banatanflorin/reductor/Memoriu justificativ de calcul.pdf

## MEMORIU JUSTIFICATIV DE CALCUL

Pm ≔3.8 kW

nm ≔2100 rpm

itot≔5

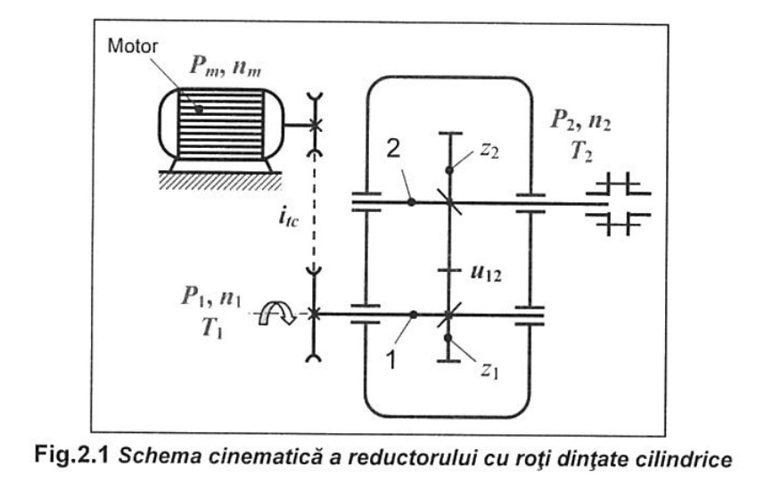
[picture p1: figure]

### 1.CALCULE PRELIMINARE:

Se adoptă itcpreliminar=1.8...2.0 => itcpreliminar≔2

u12≔――――=

itot

itcpreliminar

2.5

Se adoptă u | cu ajutorul tabelului 2.3 (pag. 24): 12STAS | u12STAS≔2.5

Se aleg materialele pentru pinion si roata:
-materialul pentru pinion: 42CrMo4 => HB1≔300 MPa -materialul pentru roată: 41Cr4 => HB2≔270 MPa

σHlim1≔1.8 ⋅HB1+200 MPa =740 MPa

σHlim2≔1.8 ⋅HB2+200 MPa =686 MPa

Se adoptă numărul de dinți, pe baza tabelului 2.1: z1≔28

z2≔z1

⋅u12STAS=70 | => | z2≔71

u12≔―=

z2
z1

2.536

ε12≔――――⋅ =

u12-u12STAS
u12STAS | 100 1.429

itc≔――=

itot

u12

1.972

10

n1≔――=

nm

itc

⎛⎝1.065 ⋅ 10³ ⎞
⎠ rpm

n2≔――=

n1

u12

420 rpm

Verificare: n2≔――=

nm

itot

420 rpm

Se adoptă, cu ajutorul tabelului 2.4:
-randamentul transmisiei prin curele trapezoidale: ηtc≔0.93 -randamentul angrenajului cu roți dințate cilindrice: ηc≔0.97 -randamentul unei perechi de rulmenți: ηrul≔0.999

P1≔Pm ⋅ηtc ⋅ηrul=3.53 kW

P2≔P1

⋅ηc

⋅ηrul=3.421 kW | n1=⎛⎝1.065 ⋅ 10³ ⎞
⎠ rpm

T1≔―――⋅ =

9550
10000

P1
n1

⎛⎝3.023 ⋅ 10⁴ ⎞
⎠ N ⋅mm

T2≔―――⋅ =

9550
10000

P2
n2

⎛⎝7.428 ⋅ 10⁴ ⎞
⎠ N ⋅mm

### 2.PREDIMENSIONAREA ANGRENAJULUI:

Se adoptă unghiul de inclinare a danturii pe cilindrul de divizare: β≔0 °

Se adoptă coeficientul lățimii dintelui: ψa≔0.24

Pe baza anexei 2.4, de la pagina 113, se adoptă factorul de utilizare, știind că transmisia este uniformă: KA≔1

Se adoptă factorul dinamic: KV≔1.2

Se adoptă factorul pentru solicitarea de contact, cu ajutorul anexei 2.6, pag. 115: ψd≔―――⋅ =

u12+1
2

ψa 0.424
KHβ≔1+0.25 ⋅ψd=1.106

Se adoptă factorul repartiției sarcinii în plan frontal: KHα≔1.2

Cu ajutorul anexei 2.8 de la pagina 118, se adoptă factorul de elasticitate a materialului roților dințate: ZE≔189.8 MPa

11

Se calculează factorul înclinării dinților pentru solicitarea de contact: Zβ≔1

Se calculează factorul punctului de rostogolire: ZH≔2.49 ⋅Zβ=2.49

Se adoptă factorul de gradului de acoperire: Zε≔0.95

Se citesc de pe graficul din anexa 2.10 de
la pagina 120, factorul de corelație a
tensiunilor de încovoiere la baza dintelui: YSa1≔1.63
YSa2≔1.8

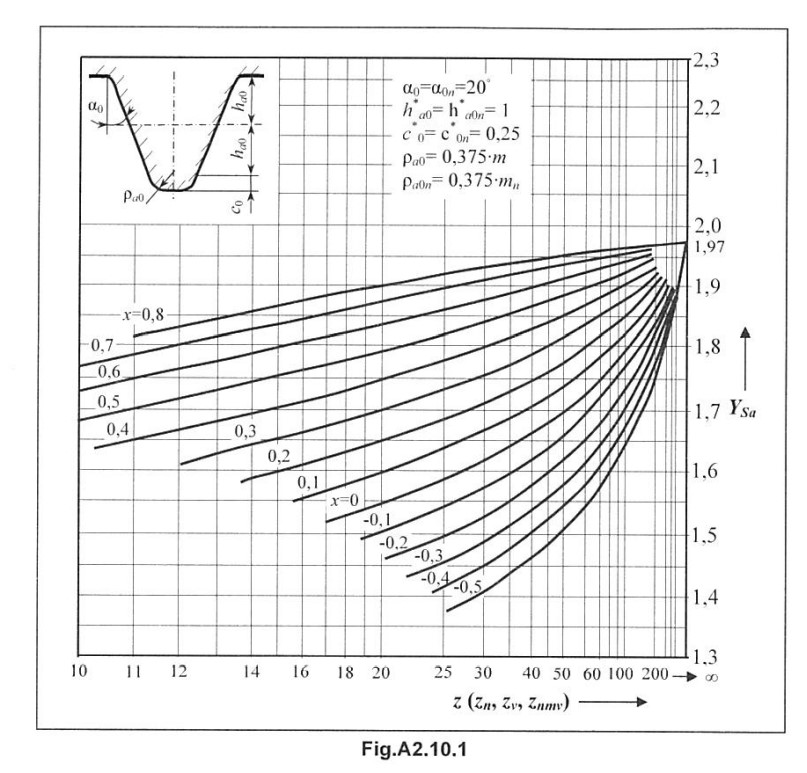
[picture p2: figure]

Cu ajutorul anexei 2.14, se adoptă factorii durabilității ZN1 ,ZN2

Se adoptă: Lh≔10000

Numărul de dinți în contact: χ ≔ și 1 | 1 | χ2≔1

NL1≔60 ⋅n1

⋅Lh

⋅χ1=⎛⎝6.692 ⋅ 10⁷ ⎞
⎠ Hz

NL2≔60 ⋅n2

⋅Lh

⋅χ2=⎛⎝2.639 ⋅ 10⁷ ⎞
⎠ Hz

Din graficul din anexa 2.14 se extrage factorii durabilității: ZN1≔1
ZN2≔1

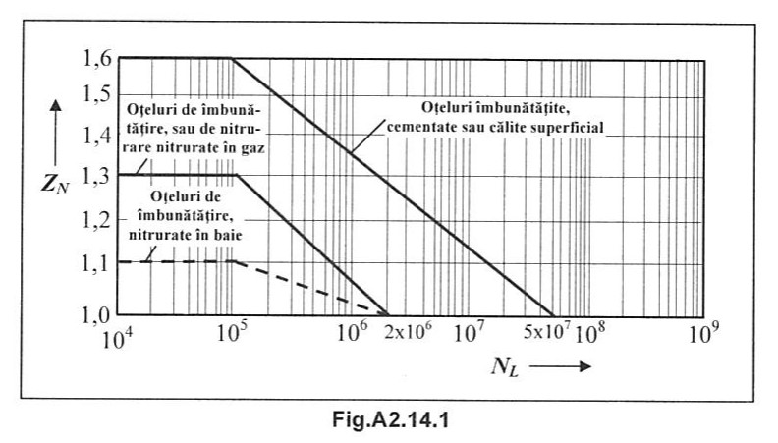
[picture p3: figure]

Din anexa 2.13, tabelul A 2.13.1 se adoptă coeficientul de siguranță minim pentru solicitarea de contact: SHmin≔1.15

σHP1≔――――=

σHlim1 ⋅ZN1

SHmin

643.478 MPa σHP2≔――――= σHlim2 ⋅ZN2 SHmin
596.522 MPa

=> σHP≔min⎛⎝σHP1 ,σHP2⎞
⎠=596.522 MPa

12

aWnec≔⎛⎝u12+1⎞
⎠
⋅ | =

3 ―――――――⋅

T ⋅ | ⋅ | ⋅ | ⋅ 1 KA KV KHβ KHα
2 ⋅ψ ⋅ | ⋅ a u12 σHP
| | | 2

⎛⎝ZE ⋅ZH ⋅Z ⋅ ε Zβ

⎞
⎠

2
99.684 mm

m≔―――=

2 ⋅aWnec
z1+z2

2.014 mm

Modulul m se standardizează, cu ajutorul tabelului 2.5 (pagina 27): m≔2 mm

a≔――――=

m⋅ ⎛⎝z1+z2

⎞
⎠
2

### 99 mm

Se standardizează distanța dintre axe, cu ajutorul tabelului 2.6 (pagina 27): aW ≔100 mm
Dacă aW >a atunci trebuie să se respecte condiția:
aW -a=1 mm
2 ⋅m=4 mm =>aW -a≤2 ⋅m

Unghiul de angrenare de referință: α≔20 °

Unghiul de angrenare real: αW ≔acos | =

⎛
⎜
⎝

――⋅

a
aW

cos ((α))

⎞
⎟
⎠

21.519 °

Se calculează involutele unghiurilor de angrenare:

invα≔tan((α))-――=

α⋅π
180 °

0.014904 rad

invαW ≔tan⎛⎝αW⎞
⎠-―――=

αW ⋅π
180 °

0.018716 rad

xs≔―――――⋅ | =

invαW -invα
2 ⋅ tan((α))

⎛⎝z1+z2

⎞
⎠ 0.518
x1≔―+ | =

xs
2

⋅

⎛
⎜
⎝

0.5-―

xs
2

⎞
⎟

⎠ ――――

log⎛⎝u12⎞
⎠

log

⎛
⎜

⎝――

z ⋅ 1 z2
100

⎞
⎟
⎠

0.334

x2≔xs-x1=0.184

y≔―――=

aW -a
m

0.5

Δy≔xs-y=0.018
13

### 3. DIMENSIONAREA ȘI VERIFICAREA ANGRENAJULUI:

### 3.1 Calculul elementelor geometrice:

Calculul diametrelor cercurilor de divizare:

d1≔m⋅ z1=56 mm

d2≔m⋅ z2=142 mm

Verificare: a≔―――=

d1+d2
2

### 99 mm

Calculul diametrelor cercurilor de bază:

db1≔d1

⋅ cos ((α))=52.623 mm

db2≔d2

⋅ cos ((α))=133.436 mm

Calculul diametrelor cercurilor de rostogolire:

dw1≔d1

⋅―――=

cos ((α))
cos ⎛⎝αW⎞
⎠

56.566 mm

dw2≔d2

⋅―――=

cos ((α))
cos ⎛⎝αW⎞
⎠

143.434 mm

Verificare: aW ≔―――=

dw1+dw2
2

100 mm

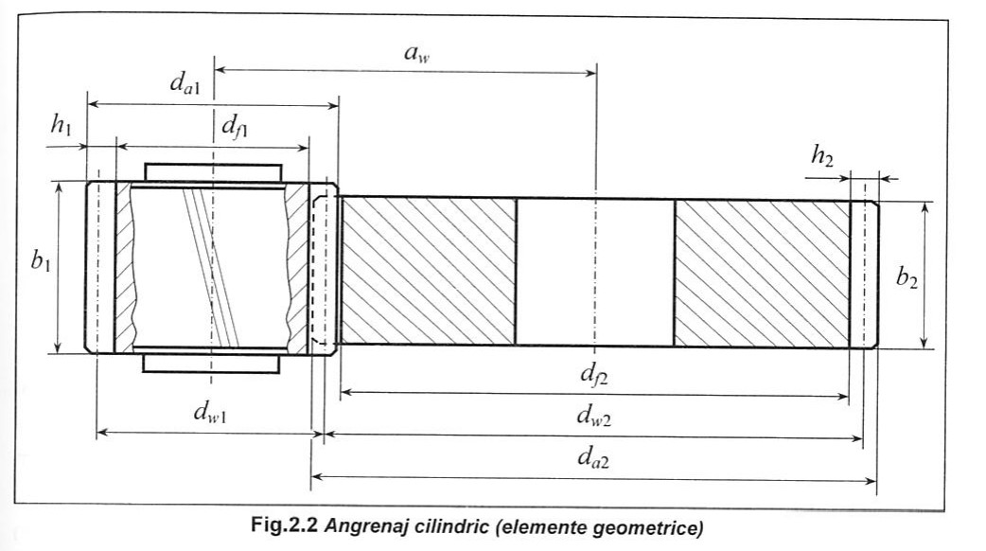
[picture p4: figure]

Se adoptă coeficientul înălțimii capului de referință: han≔1

Se adoptă coeficientul jocului de referință la capul dintelui: cn≔0.25 14

Calculul diametrelor cercurilor de cap:

da1≔m⋅ ⎛⎝z1+2 ⋅ ⎛⎝han+x1-Δy⎞ ⎠

⎞
⎠=61.263 mm

da2≔m⋅ ⎛⎝z2+2 ⋅ ⎛⎝han+x2-Δy⎞ ⎠

⎞
⎠=146.663 mm

Calculul diametrelor cercurilor de picior:

df1≔m⋅ ⎛⎝z1-2 ⋅ ⎛⎝han+cn-x1

⎞
⎠

⎞
⎠=52.337 mm

df2≔m⋅ ⎛⎝z2-2 ⋅ ⎛⎝han+cn-x2

⎞
⎠

⎞
⎠=137.737 mm

Calculul unghiurilor de presiune pe cercurile de cap:

αa1≔acos | =

⎛
⎜
⎝

――⋅

d1

da1

cos ((α))

⎞
⎟
⎠

30.799 °

αa2≔acos | =

⎛
⎜
⎝

――⋅

d2

da2

cos ((α))

⎞
⎟
⎠

24.52 °

Calculul grosimii dinților pe cercurile de divizare:

S1≔⎛⎝0.5 ⋅π +2 ⋅x1 | ⋅ tan((α))⎞
⎠

⋅m=3.628 mm

S2≔⎛⎝0.5 ⋅π +2 ⋅x2 | ⋅ tan((α))⎞
⎠

⋅m=3.41 mm

Calculul grosimii dinților pe cercurile de cap:
invαa1≔tan⎛⎝αa1⎞ | ⎠-―――= α ⋅ a1 π 180 °
0.058554 rad
invαa2≔tan⎛⎝αa2⎞ | ⎠-―――= α ⋅ a2 π 180 °
0.028195 rad

Sa1≔⎛⎝

⎛⎝

invα-invαa1⎞
⎠
| ⋅m⋅ z1+S1

⎞
⎠

⋅―――=

cos ((α))
cos ⎛⎝αa1⎞
⎠

1.295 mm

Sa2≔⎛⎝

⎛⎝

invα-invαa2⎞
⎠
| ⋅m⋅ z2+S2

⎞
⎠

⋅―――=

cos ((α))
cos ⎛⎝αa2⎞
⎠

1.573 mm

Calculul înălțimii dintelui:

h≔m⋅ ⎛⎝2 ⋅han+cn-Δy⎞ | ⎠=4.463 mm
15

Calculul lățimii danturii celor două roți:

b2≔ψa

⋅aW =24 mm

b1≔b2+3 mm =27 mm

Calculul gradului de acoperire:

εα≔――――――――――――――=

d
a1
- | + | -

### 2 db1

2 - da2

### 2 db2

2 2 ⋅aW ⋅ sin⎛⎝αW⎞
⎠
2 ⋅π⋅m⋅ cos ((α))

1.598

Elemente de control:

Calculul numărului de dinți:

N1≔z1

⋅――+ =

α
180 °

0.5 3.611 => N1≔4

N2≔z2

⋅――+ =

α
180 °

0.5 8.389 => N2≔8

Calculul cotelor peste dinți:

WN1≔m⋅ ⎛⎝π⋅ ⎛⎝N1-0.5⎞
⎠+z1

⋅invα⎞
⎠

⋅ cos ((α))+2 ⋅m⋅x1

⋅ sin((α))=21.906 mm

WN2≔m⋅ ⎛⎝π⋅ ⎛⎝N2-0.5⎞
⎠+z2

⋅invα⎞
⎠

⋅ cos ((α))+2 ⋅m⋅x2

⋅ sin((α))=46.523 mm

Calculul corzii constante și înălțimea la coarda constantă:

Sc1≔m⋅ | =

⎛
⎝0.5 ⋅π⋅ cos ((α)) +

2
x ⋅ 1 sin((2 ⋅α))

⎞
⎠ 3.204 mm
Sc2≔m⋅ | =

⎛
⎝0.5 ⋅π⋅ cos ((α)) +

2
x ⋅ 2 sin((2 ⋅α))

⎞
⎠ 3.011 mm

hc1≔0.5 ⋅ ⎛⎝da1-d1-Sc1 ⋅ tan((α))⎞ ⎠=2.048 mm

hc2≔0.5 ⋅ ⎛⎝da2-d2-Sc2 ⋅ tan((α))⎞
⎠=1.784 mm

Abateri și toleranțe:

Conform anexei 2.20 de la pagina 135, se vor stabili toleranțele și abaterile pentru angrenaj:

Adopt treapta de precizie: 7
Adopt tipul ajustajului: B
16

Din tabelul A2.20.1, se adopta toleranța bătăi radiale a danturii: Fr1≔36 μm
Fr2≔50 μm

Din tabelul A2.20.2, se adoptă abaterea minimă a cotei peste dinți: EWS1≔100 μm
EWS2≔120 μm

Din tabelul A2.20.3, se adoptă toleranța cotei peste dinți:
TW1≔80 μm
TW2≔100 μm

Din tabelul A2.20.4, se adoptă abaterea superioară a grosimii dintelui pe coarda constantă:
ECS1≔100 μm
ECS2≔140 μm

Din tabelul A2.20.5, se adoptă toleranța grosimii dintelui pe coarda constantă: TC1≔90 μm
TC2≔140 μm

Verificarea restricțiilor funcțional-constructive și de control:

Pentru evitarea funcționării neuniforme trebuie să fie îndeplinită condiția:

1.3≤εα≤2 | ( ε = | ) α 1.598

Roțile sunt efectuate din oțeluri de cementare sau călite superficial, astfel trebuie să se îndeplinească restricțiile de evitare a ascuțirii dinților:

Sa1≥0.4 ⋅m | Sa2≥0.4 ⋅m
(S = | , | , | ) a1 1.295 mm Sa2=1.573 mm m=2 mm

Restricțiile de evitare a interferenței dinților:

x1min≔―――=

14-z1
17
| -0.824 | | x2min≔―――=

14-z2
17

-3.353

x1min≤x1 | x2min≤x2

17

### 3.2 VERIFICAREA ANGRENAJULUI:

Se determina viteza periferică a angrenajului:

ν≔――――=

π⋅dw1 ⋅n1
6

3.303 ―m
s

Yβ≔1

ZH≔ | =
―――2――― sin⎛ | ⋅ ⎝αW⎞
| ⎠ cos ⎛⎝αW⎞ ⎠

2.421

Zε≔ | =
――

4-εα
3

0.895

Se adoptă ulei TIN 82 EP (TIN-ulei pentru transmisii industriale, EP-adezivi de extreme presiuni)

Se adoptă vâscozitatea cinematică, conform anexei 2.18,tabelul A2.18.2 de la pagina 132: v≔85 stokes

Cu ajutorul anexei 2.18,
graficul A2.18.1, se va
adopta factorul de
ungere: ZL≔0.98

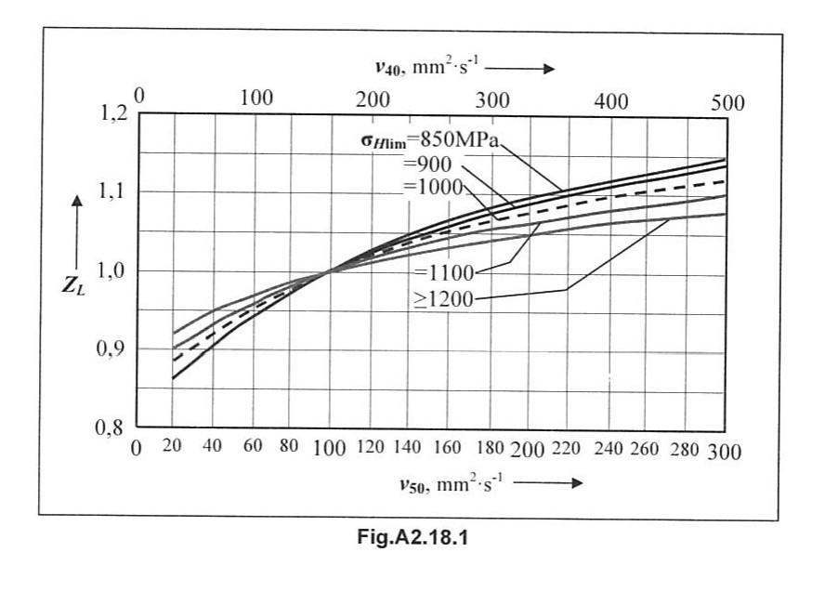
[picture p5: figure]

Conform anexei 2.15, se va adopta rugozitatea flancurilor și a zonelor de racordare:

Din tabelul A2.15.1 => R ≔ | și a1 | 0.4 | Ra2≔0.4
Rz1≔4.4 ⋅Ra1 | =

0.97 1.809

Rz2≔4.4 ⋅Ra2 =

0.97 1.809

Rz100≔―――⋅ | | =

Rz1+Rz2
2

―100―mm―aW
1.809

18

Conform graficului A2.15.1, se adoptă factorul rugozității flancurilor: ZR≔1.08

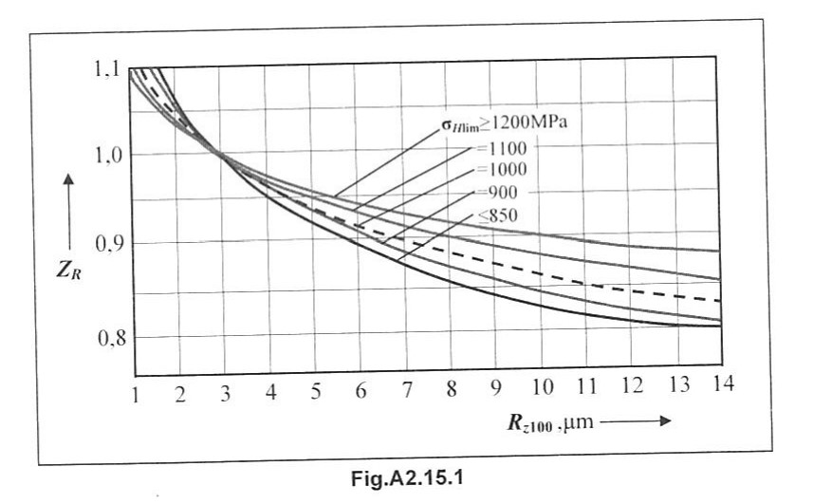
[picture p6: figure]

Conform anexei 2.16, se va adopta factorul de viteză: Zv≔0.94

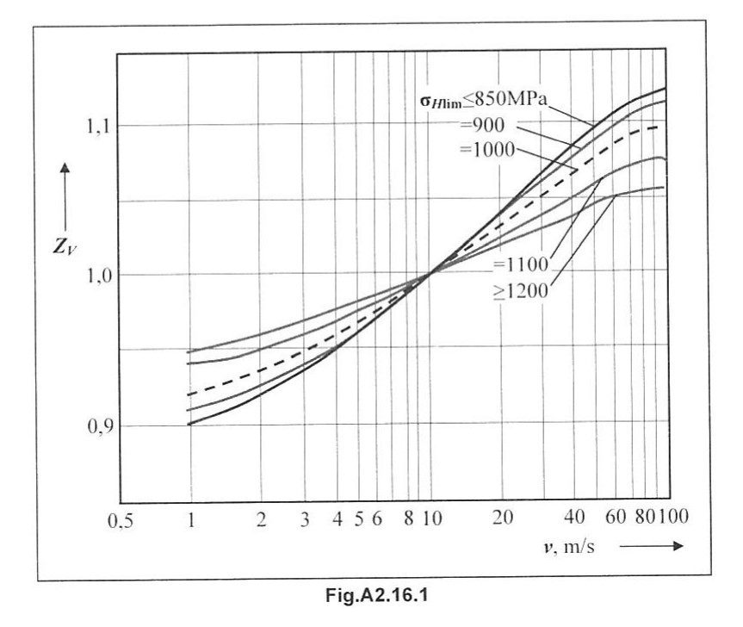
[picture p7: figure]

Conform anexei 2.17, se va adopta factorul raportului durităților flancurilor dințate:

HB≔min⎛⎝HB1
,HB2

⎞
⎠=270 MPa

ZW ≔1.2-―――――=

HB-130 MPa
1700 MPa

1.118

Tensiunea efectivă maximă de contact:

σH≔―――――⋅ | =
ZE ⋅Z ⋅ | ⋅ ε ZH Zβ
aW
――⋅ | ⋅ | ⋅ | ⋅ | ⋅

T1
2 ⋅ b2

KA KV KHβ KHα ――――

⎛⎝u12+1⎞
⎠

3

u12

543.65 MPa
19

Factorul de siguranță la solicitarea de contact:

ZN≔1

SH≔―――⋅ | ⋅ ⋅ | ⋅ ⋅ | =

σHlim2
σH

ZN ZL ZR Zv ZW 1.403

=> SH ≥SHmin
SHmin=1.15

Factorii rugozității flancurilor pentru solicitarea de încovoiere: YR1≔1 și YR2≔1

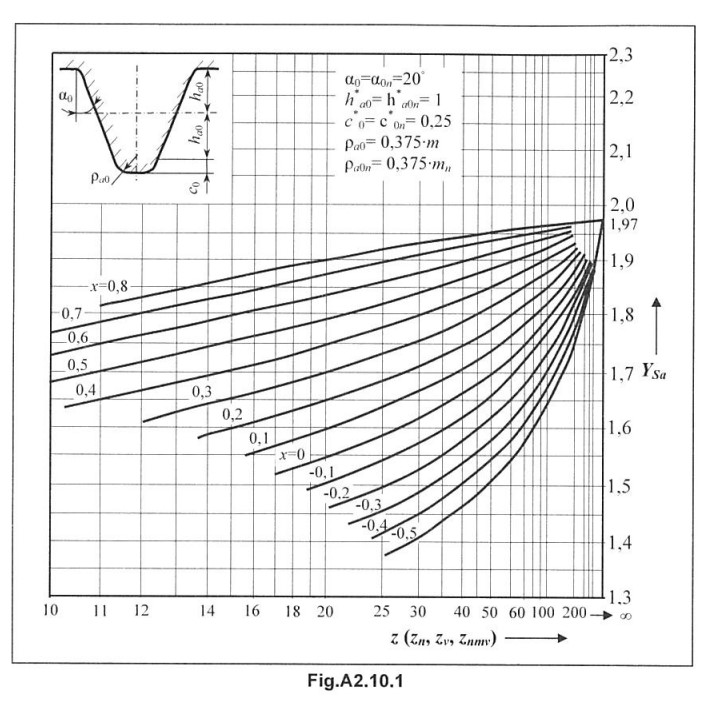
[picture p8: figure]

Cu ajutorul anexei 2.10, graficul
A2.10.1, se va adopta factorul de corecție a tensiunilor de încovoiere la baza dintelui: YSA≔1.75

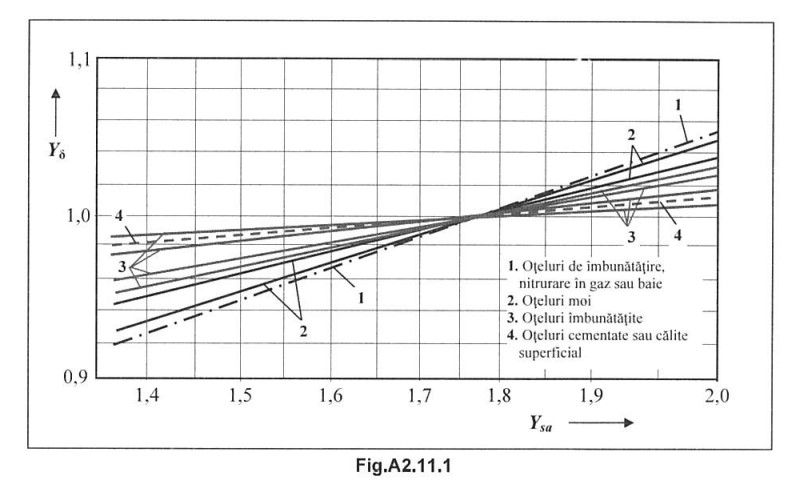
[picture p9: figure]

Cu ajutorul anexei 2.11, graficul A2.11.1, se va adopta factorul relativ de sensibilitate al materialului la concentratorul de tensiuni de la baza dintelui la durabilitate nelimitată: Yδ≔0.99

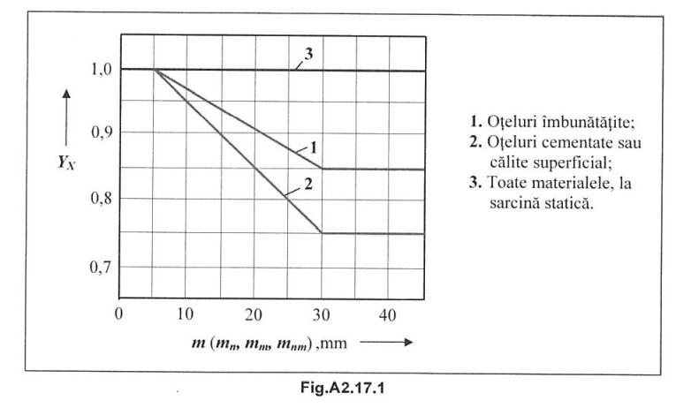
[picture p10: figure]

Cu ajutorul anexei 2.17, se va adopta factorul dimensional pentru solicitarea de încovoiere: Yx≔1

20

### 4. CALCULUL FORȚELOR DIN ANGRENAJ

Forțele tangențiale:

Ft1≔――=

2 ⋅T1

dw1

⎛⎝1.069 ⋅ 10³ ⎞

⎠ N | Ft2≔Ft1=⎛⎝1.069 ⋅ 10³ ⎞
⎠ N

Forțele radiale:

Fr1≔Ft1 ⋅ tan((α))=389.045 N | Fr2≔Fr1=389.045 N

Forțele axiale:

Fa1≔Ft1 ⋅ tan((β))=0 N | Fa2≔Fa1=0 N

Forțele normale:

Fn1≔ F
t1
+ | + | =

### 2 Fr1

### 2 Fa1

2 ⎛⎝1.137 ⋅ 10³ ⎞
⎠ N

Fn2≔Fn1=⎛⎝1.137 ⋅ 10³ ⎞
⎠ N

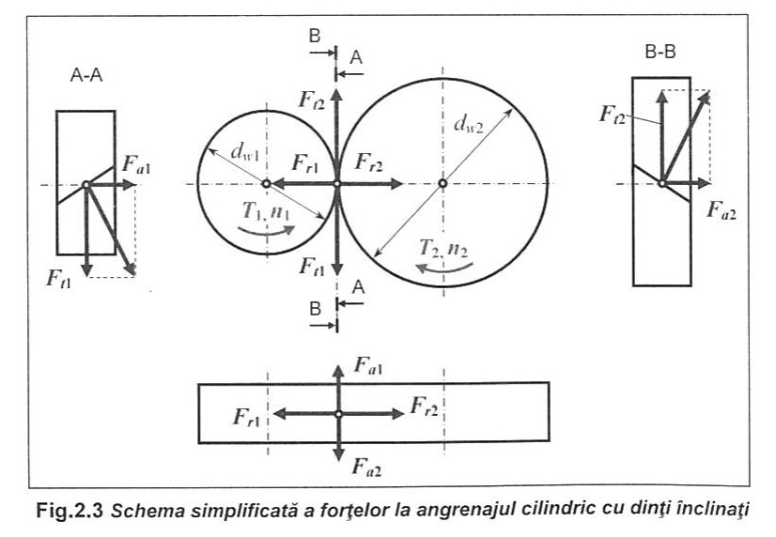
[picture p11: figure]

### 5. PROIECTAREA ȘI CALCULUL ARBORILOR:

### 5.1 Proiectarea formei arborelui de intrare din reductor:

Materialul arborelui de intrare coincide cu materialul pinionului, deci arborele de intrare este efectuat din : 42CrMo4

21

Cu ajutorul anexei 2.1 obținem rezistența la rupere a arborelui de intrare: Rm1≔950 MPa

Tc1≔T1

⋅――――=

550 MPa

Rm1

17.502 N ⋅m

Cu ajutorul tabelului 3.1, pagina 58, se standardizează momentul transmisibil și diametrul nominal al capătului de arbore:

Tc1≔21.2 N ⋅m | dca1≔20 mm

Cu ajutorul tabelului 3.2, pagina 58, se adoptă lungimea capetelor de arbore:

lca1≔36 mm

Cu ajutorul anexei 3.1 se adoptă dimensiunile penei de fixare:

bpana1≔6 mm | hpana1≔6 mm

tpana1≔3.5 mm

lpana1≔lca1-4 mm =32 mm

Asigurarea de capăt de arbore:

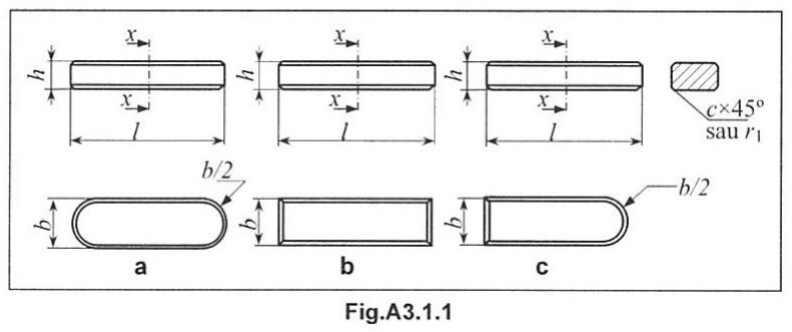
[picture p12: figure]

dca1≤28 => Asigurarea este realizată cu un șurub și două șaibe

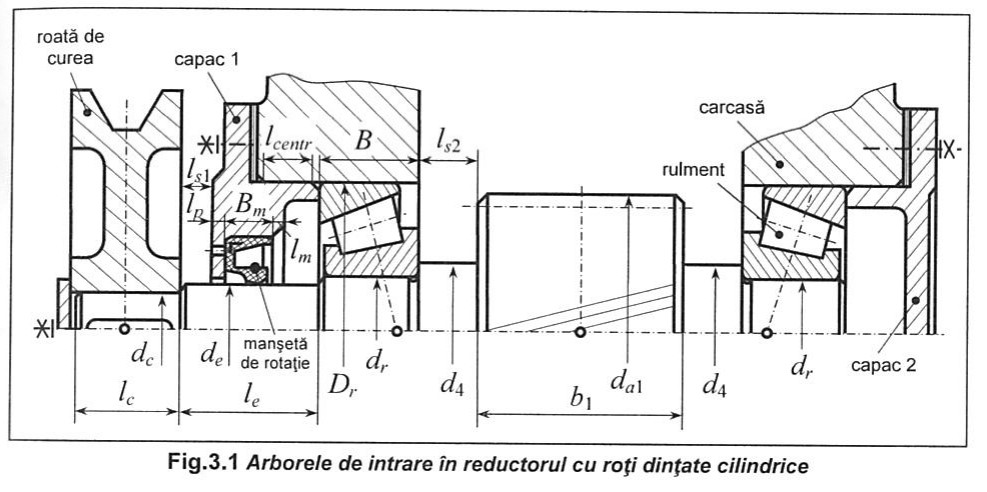
[picture p13: figure]

Alegem dimensiunile șurubului cu ajutorul tabelului 3.3:

Dmax1≔28 mm | bsurub1≔5 mm | filet M6 | d1surub1≔7 mm
gsurub1≔2 mm | hsurub1≔5 mm | l
| | surub1≔16 mm | fmax1≔3 mm
22

Alegem dimensiunile pentru șaibele de siguranță cu ajutorul tabelului 3.4:

d2saiba1≔6.4 mm | g1saiba1≔0.5 mm l
| | saiba1≔18 mm | rsaiba1≔4 mm
D1saiba1≔12.5 mm | bsaiba1≔4.5 mm | l1saiba1≔9 mm | r1saiba1≔4 mm

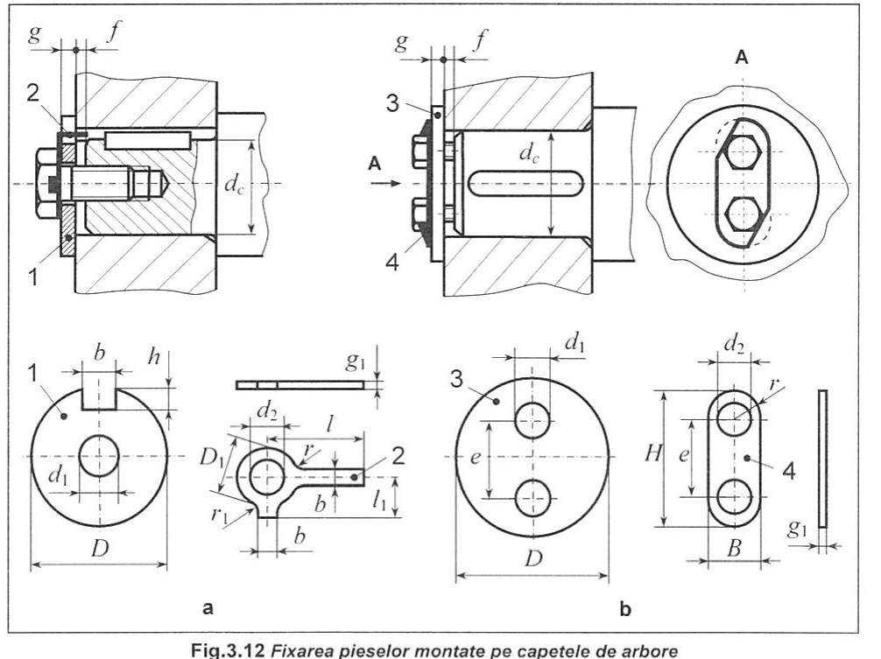
[picture p14: figure]

Se adoptă manșeta de rotație cu ajutorul anexei 3.6:

de1≔1.2 ⋅dca1=24 mm

=> de1STAS≔25 mm

Diametrul exterior al manșetei: Dm1≔40 mm

Lățimea manșetei: Bm1≔7 mm

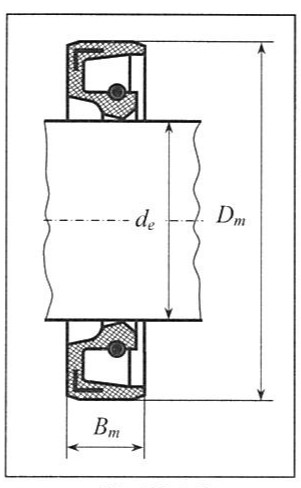
[picture p15: figure]

Pentru dimensionarea rulmenților radiali cu bile ne ajutam de anexa 3.2 și de condiția: dr1≥de1STAS

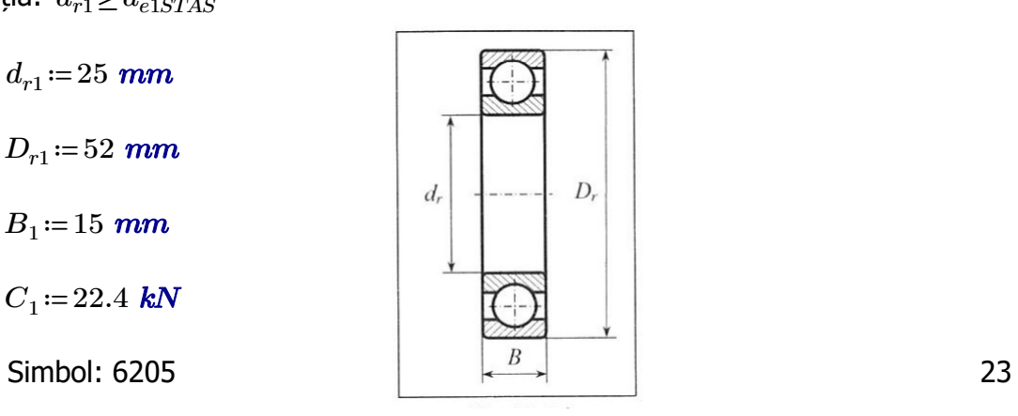
[picture p16: figure]
Simbol: 6205

dr1≔25 mm

Dr1≔52 mm

B1≔15 mm

C1≔22.4 kN

Se adoptă cota de siguranță: l
s1≔8 mm

d41≔dr1+5 mm =30 mm

### 5.2 Proiectarea formei arborelui de ieșire din reductor:

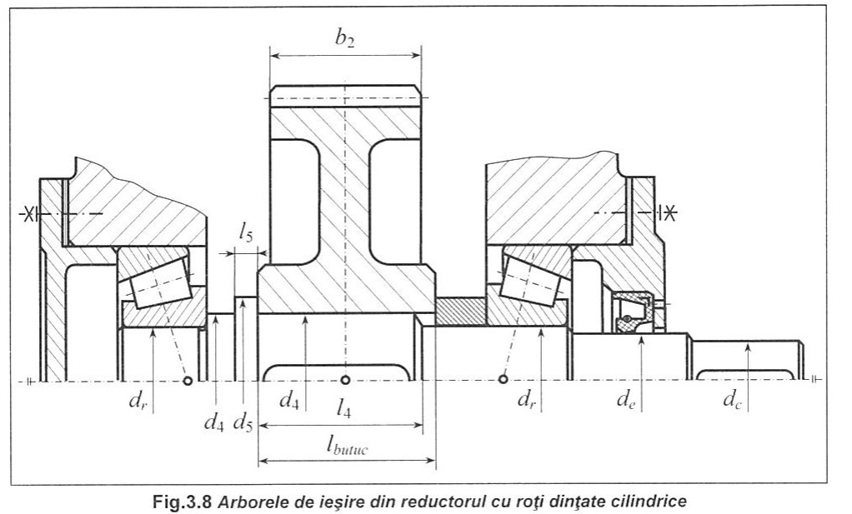
[picture p17: figure]

Arborele de ieșire este efectuat din materialul: 1C55

Cu ajutorul tabelului 3.1 obținem rezistența la rupere a arborelui de ieșire: Rm2≔720 MPa

Tc2≔T2

⋅――――=

550 MPa

Rm2

56.745 N ⋅m

Cu ajutorul tabelului 3.1, pagina 58, se standardizează momentul transmisibil și diametrul nominal al capătului de arbore:

Tc2≔69 N ⋅m

dca2≔28 mm

Cu ajutorul tabelului 3.2 se adoptă lungimea capetelor de arbore: lca2≔60 mm

Cu ajutorul anexei 3.1 se adoptă dimensiunile penei paralele:

bpana2≔8 mm | hpana2≔7 mm
lpana2≔50 mm | tpana2≔4 mm
24

Asigurarea de capăt de arbore:

dca2≤28 => Asigurarea este realizată cu un șurub și două șaibe

Alegem dimensiunile șurubului cu ajutorul tabelului 3.3:

Dmax2≔36 mm | bsurub2≔8 mm | filet: M6 | d1surub2≔7 mm
gsurub2≔2.5 mm | hsurub2≔7 mm | l
| | surub2≔16 mm | fmax2≔3 mm

Alegem dimensiunile pentru șaibele de siguranță cu ajutorul tabelului 3.4:

d2saiba2≔6.4 mm | bsaiba2≔4.5 mm | l
| | saiba≔18 mm | rsaiba2≔4 mm
D1saiba2≔12.5 mm | g1saiba2≔0.5 mm l1saiba2≔9 mm | r1saiba2≔4 mm

Se adoptă manșeta de rotație cu ajutorul anexei 3.6:

de2≔1.2 ⋅dca2=33.6 mm

de2STAS≔35 mm

Diametrul exterior al manșetei: Dm2≔50 mm

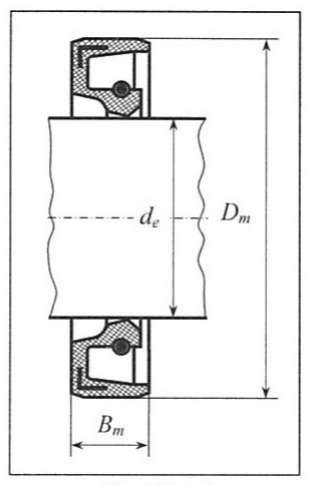
[picture p18: figure]

Lățimea manșetei: Bm2≔8 mm | 25

Pentru dimensionarea rulmenților radiali cu bile ne ajutam de anexa 3.2 și de condiția: dr2≥de2STAS

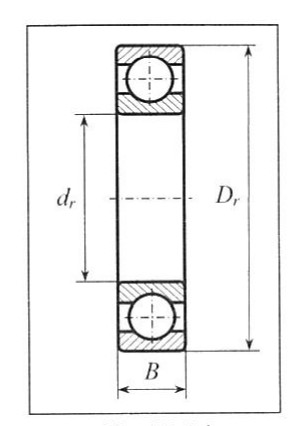
[picture p19: figure]

dr2≔35 mm

Dr2≔72 mm

B2≔16 mm

C2≔33.5 kN

Simbol: 6207

d42≔dr2+4 mm =39 mm

Se adoptă lungimea butucului: lbutuc≔50 mm

l4≔lbutuc-3 mm =47 mm

### 6. PROIECTAREA FORMEI CONSTRUCTIVE A ROȚII DINȚATE:

Roțile dințate sunt efectuate din
materialul: 42CrMo4

δrd≔3 ⋅m=6 mm

δ1rd≔0.28 ⋅ b2=6.72 mm

dcrd≔1.6 ⋅d42=62.4 mm

dird≔df2-2 ⋅ δrd=125.737 mm

lrd≔1.3 ⋅d42=50.7 mm

dgrd≔0.5 ⋅ ⎛⎝dird+dcrd⎞
⎠=94.069 mm

dord≔――――=

dird-dcrd
4

15.834 mm

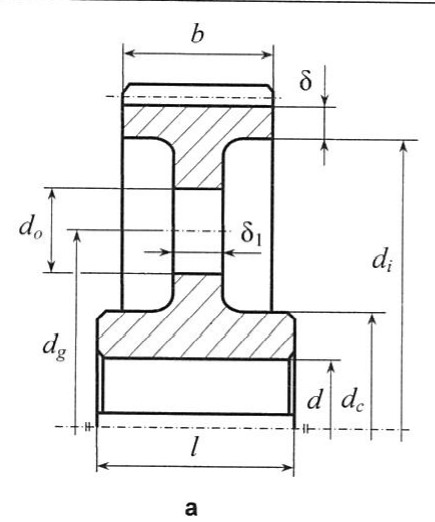
[picture p20: figure]

26

### 7. PROIECTAREA CARCASEI REDUCTORULUI ȘI A ACESORIILOR CARCASEI:

### 7.1 Proiectarea carcasei:

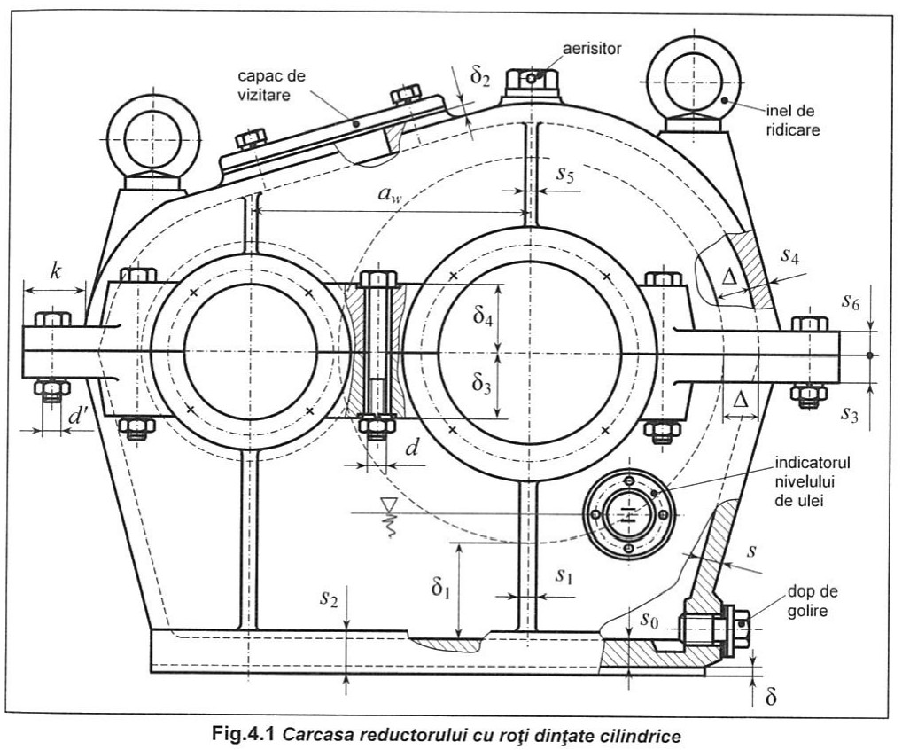
[picture p21: figure]

Grosimea peretelui interior: s≔0.06 ⋅aW =6 mm => s≥5 mm

Grosimea fundului carcasei: s0≔1.25 ⋅ s=7.5 mm

Grosimea nervurilor carcasei inferioare: s1≔0.8 ⋅ s=4.8 mm

Dimensiunile tălpii reductorului: s2≔2 ⋅ s=12 mm

δ≔0.4 ⋅ s=2.4 mm

Grosimea flanșei carcasei inferioare: s3≔1.5 ⋅ s=9 mm

Grosimea carcasei superioare: s4≔0.85 ⋅ s=5.1 mm

Grosimea nervurilor carcasei superioare: s5≔0.8 ⋅ s4=4.08 mm

Grosimea flanșei carcasei superioare: s6≔1.5 ⋅ s4=7.65 mm | 27

Distanța minimă de la roțile dințate la pereții carcasei:
Δ1≔1.2 ⋅ s=7.2 mm => Δ1≔8 mm

Distanța de la roata dințată cu diametru mai mare până la fundul reductorului: δ1c≔35 mm

Bosajul capacului de vizitare: δ2c≔4 mm

Dimensiunile carcaselor în zona lagărelor cu rulmenți: δ3c≔2 ⋅ s3=18 mm δ4c≔2 ⋅ s6=15.3 mm

Asamblarea celor două carcase, superioară și inferioară, se realizează prin intermediul flanșelor și a șuruburilor.

Cu ajutorul tabelului 4.1 de la pagina 86, se adoptă diametrele șuruburilor de fixare: d≔10 mm (filet M10)
dg≔11 mm
d'≔8 mm (filet M8)
d'g≔9 mm

Lățimea flanșei: k≔2.7 ⋅d'=21.6 mm

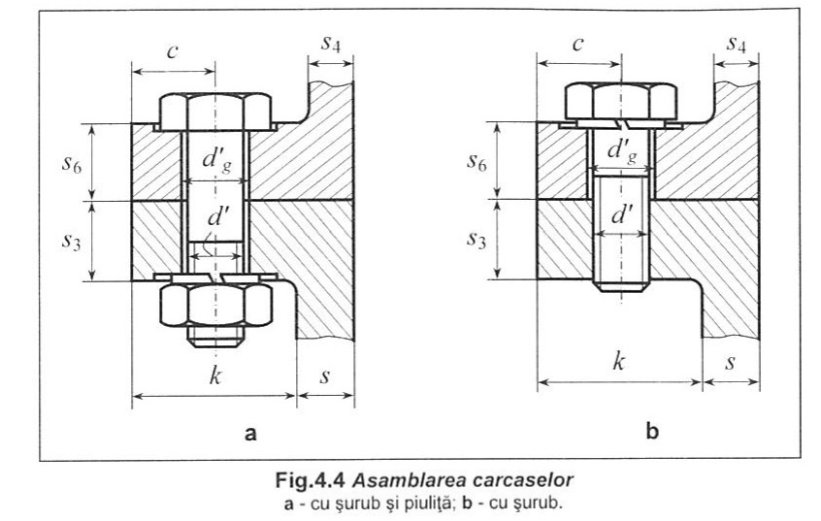
[picture p22: figure]

Distanța de la axa șuruburilor la marginea flanșei: c≔0.5 ⋅k=10.8 mm

Centrarea carcasei superioare față de carcasa inferioară se realizează prin intermediul a două știfturi cilindrice.

dst≔0.75 ⋅d'=6 mm

Se standardizează știftul cu ajutorul anexei 4.8: dst≔6 mm l

st≔40 mm

28

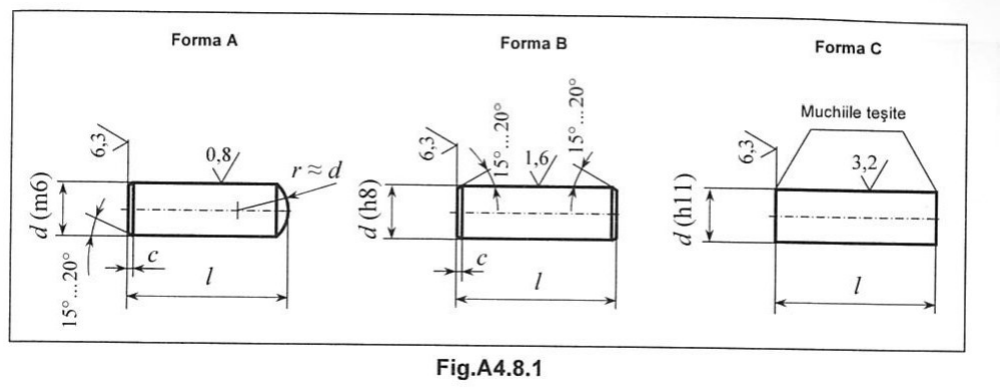
[picture p23: figure]

Dimensionarea bosajelor:

D1≔Dr1=52 mm | D2≔Dr2=72 mm

Db1≔D1+4.2 ⋅dst+5 mm =82.2 mm

Db2≔D2+4.2 ⋅dst+5 mm =102.2 mm

### 7.2 Proiectarea accesoriilor carcasei:

### 7.2.1 Capace de fixare a rulmenților:

ARBORELE DE INTRARE:

Din≔Dr1=52 mm

dsin≔6 mm

nin≔4

D1in≔Din+2.5 ⋅dsin=67 mm

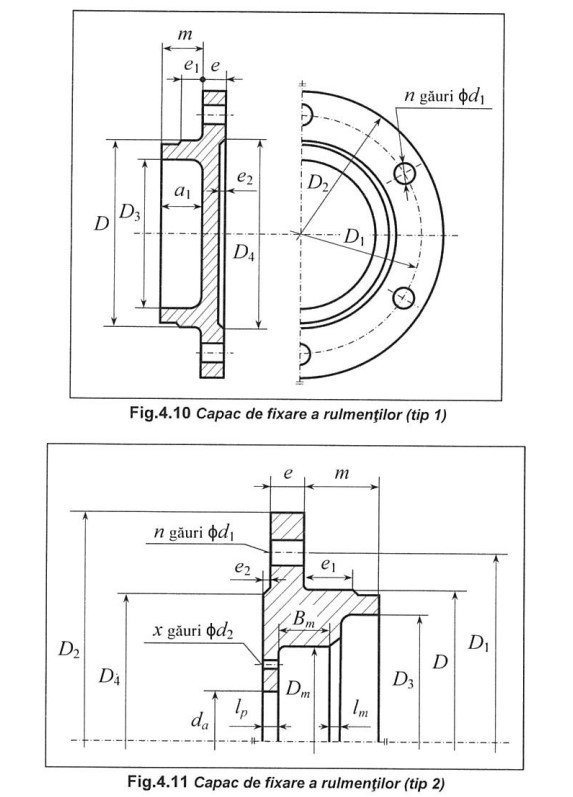
[picture p24: figure]

D2in≔D1in+2.5 ⋅dsin=82 mm

D3in≔0.9 ⋅ Din=46.8 mm

ein≔1.2 ⋅dsin=7.2 mm

d1in≔dsin+2 mm =8 mm

D4in≔D1in-3 ⋅dsin=49 mm

e1in≔5 mm | e2in≔3 mm
lpin≔4 mm | lmin≔2 mm

dain≔de1+4 mm =28 mm

29

ARBORELE DE IEȘIRE:

Die≔Dr2=72 mm

dsie≔8 mm

nie≔4

D1ie≔Die+2.5 ⋅dsie=92 mm

D2ie≔D1ie+2.5 ⋅dsie=112 mm

D3ie≔0.9 ⋅ Die=64.8 mm

eie≔1.2 ⋅dsie=9.6 mm

d1ie≔dsie+2 mm =10 mm

D4ie≔D1ie-3 ⋅dsie=68 mm

e1ie≔5 mm | e2ie≔3 mm
lpie≔4 mm | lmie≔2 mm

daie≔de2+4 mm =37.6 mm

### 7.2.2 Capace de vizitare:

Se adoptă capac de vizitare dreptunghiular, acesta fiind standardizat în
tabelul 4.7 de la pagina 92.
a≔80 mm | e≔116 mm | l3≔88 mm | Șuruburi pt. acest capac:
b≔100 mm | l1≔70 mm | h≔3 mm | Filet M4 | l≔10 mm
c≔96 mm | l2≔108 mm | R≔8 mm | nr≔6 | hg≔1 mm

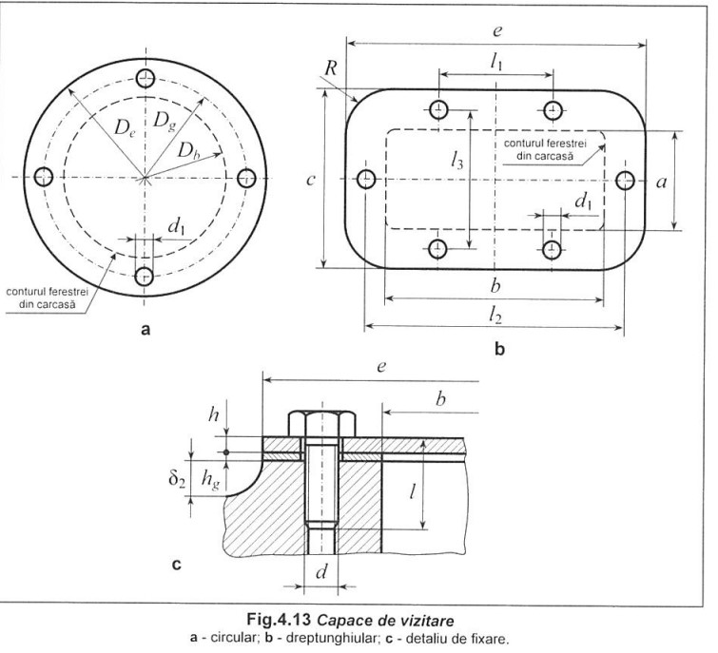
[picture p25: figure]

d1≔4.5 mm

30

### 7.2.3 Dopuri de golire:

Cu ajutorul tabelului 4.8, de la pagina 93, se adoptă dimensiunile pentru dopul de golire.
Filet: M12 | pd≔1.25 mm | Dd≔20 mm
Hd≔5.5 mm | ld≔12 mm | ad≔3 mm
Sd≔13 mm

### 7.2.4 Aerisitoare:

Cu ajutorul tabelului 4.9, de la pagina 93, se adoptă dimensiunile pentru aerisitor.
Filet: M10 | Da≔13 mm | La≔16 mm
la≔8 mm | d1a≔3 mm | aa≔2 mm
Sa≔14 mm

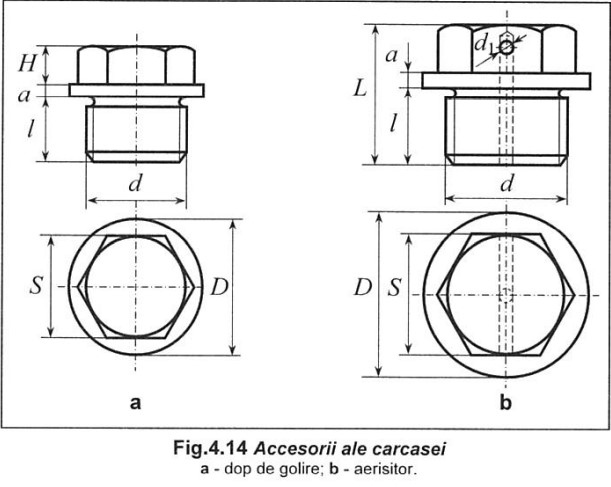
[picture p26: figure]

### 7.2.5 Indicatoare de nivel de ulei:

Viteza periferică a roții dințate 2:

νw2≔――――=

π⋅dw2 ⋅n2
6

3.303 ―m
s

νw2>2 ―m
s

=> k≔6

H1≔― | + | =

1
2

⎛⎝da2-0.95 ⋅df2⎞
⎠ δ1c 42.907 mm

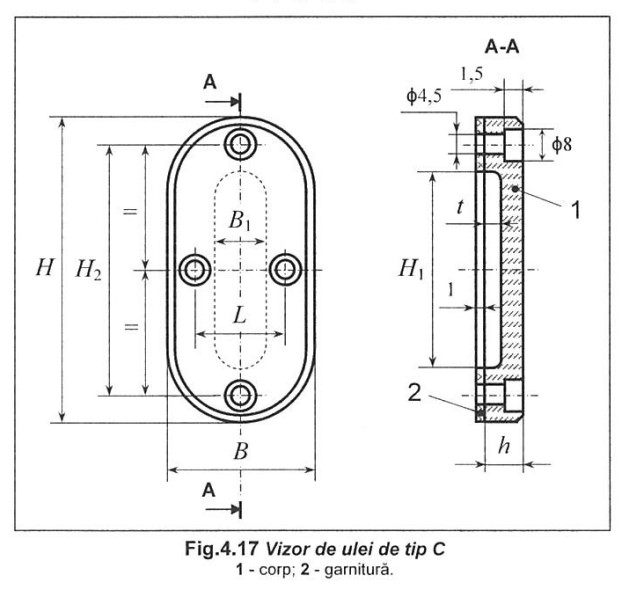
[picture p27: figure]

H2≔――+ | =
da2 k | δ1c 59.444 mm

31

Se alege vizor de ulei de tip C de mărimea 1:

B≔32 mm | B1≔10 mm | H≔50 mm | H1≔28 mm
H2≔36 mm | L≔22 mm | h≔4 mm

### 7.2.6 Inele de ridicare:

Cu ajutorul anexei 4.7 se adoptă valorile pentru inele de ridicare a reductorului: se adopta filetul M10

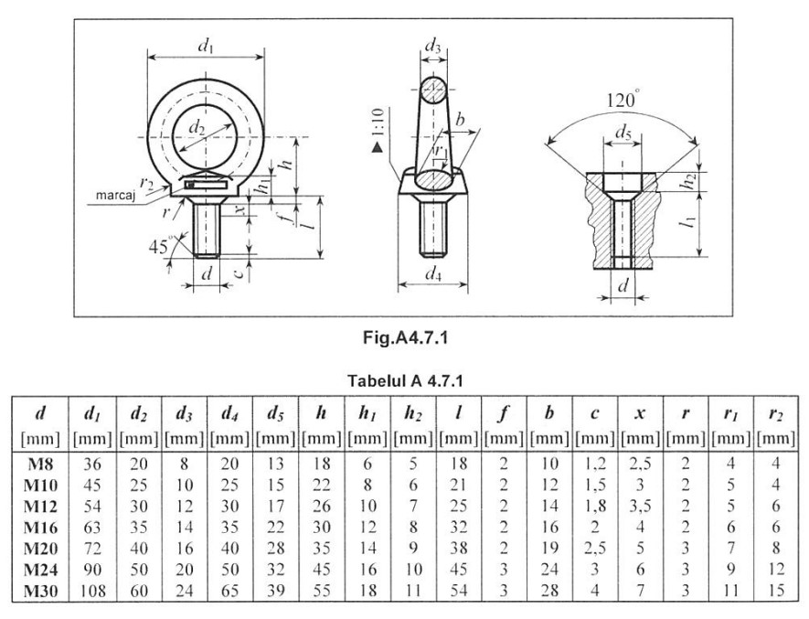
[picture p28: figure]

### 8. PROIECTAREA TRASMISIEI PRIN CURELE TRAPEZOIDALE

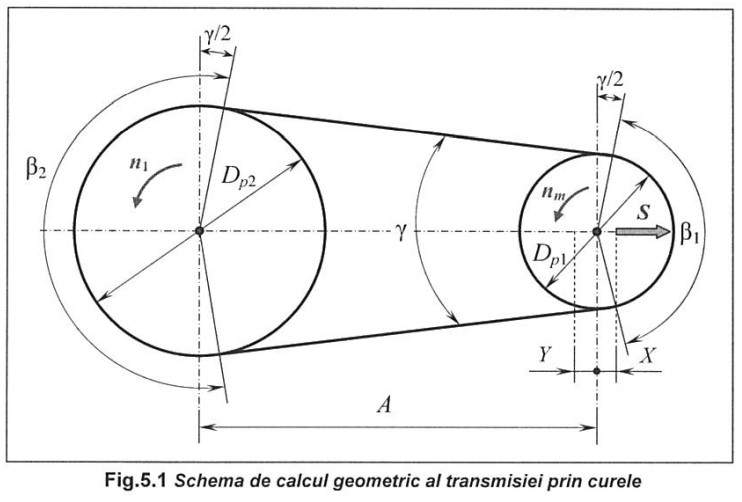
[picture p29: figure]

32

Cu ajutorul tabelului 5.1, de la pagina 99, se adoptă diametrul primitiv al roții mici: Dp1≔90 mm

Dp2≔itc ⋅ Dp1=177.465 mm

Dp1+ Dp2=267.465 mm

1.5 ⋅ ⎛⎝Dp1+ Dp2⎞
⎠=401.197 mm

Dp1+ Dp2≤Ap≤1.5 ⋅ ⎛⎝Dp1+ Dp2⎞
⎠ | => | Ap≔320 mm

Lungimea primitivă a curelei:

Lp≔2 ⋅Ap+π⋅――――+ | =

Dp1+ Dp2
2 ――――

⎛⎝Dp2- Dp1⎞
| ⎠
| 2
4 ⋅Ap | | ⎛⎝1.066 ⋅ 10³ ⎞ ⎠ mm

Cu ajutorul tabelului 5.2, de la pagina 100, se adoptă lungimea curelei: L≔1120 mm
cL≔0.93

Distanța reală dintre axe:

p≔0.25 ⋅L-0.393 ⋅ ⎛⎝Dp1+ Dp2⎞ ⎠=174.886 mm

q≔0.125 ⋅ ⎛⎝Dp2- Dp1⎞
⎠ =

2
956.261 mm²

A≔p+ p-=

2
q 347.017 mm

Unghiul dintre ramurile curelei:

γ≔2 ⋅asin | =

⎛
⎜

⎝――――

Dp2- Dp1
2 ⋅A

⎞
⎟
⎠

14.48 °

Unghiul de înfășurare pe roata mică de curea:

β1≔180 ° -γ=165.52 °

Viteza periferică a curelei:

ν≔――――=

π⋅ D ⋅ p1 nm
6

10.363 ―m
s

Numărul preliminar de curele:

cf≔1.25 | 33

cβ≔0.99

Cu ajutorul tabelului 5.4, de la pagina 101, se adoptă puterea nominală transmisă de curea: P0≔2.86 kW

zo≔―――=

c ⋅ f Pm
c ⋅ ⋅ L cβ P0

1.804

Numărul de curele:

Cu ajutorul tabelului 5.5, de la pagina 102, se adoptă coeficientul numărului de curele: cz≔0.95

z≔―=

zo
cz
1.899 | => | z≔2

Frecvența încovoierilor curelei:

f≔2 ⋅―=

ν
L

18.506 Hz
=> f≤fa
fa≔40 Hz

Forța periferică transmisă: F≔――=

Pm
ν

366.686 N

Forța de întindere a curelei: S≔1.7 ⋅F=623.367 N

Proiectarea formei roții de curea:

Pentru curele trapezoidale de tipul SPZ dimensiunile sunt:

lp≔8.5 mm | n≔2.5 mm
m≔9 mm | f≔8 mm
e≔12 mm | r≔0.5 mm
α≔38 ° | ( D > | ) p1 80 mm

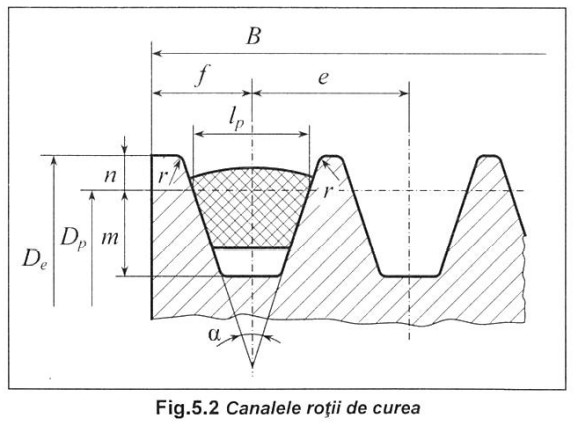
[picture p30: figure]

Diametrul exterior al roții: | De≔Dp2+2 ⋅n=182.465 mm
Lățimea roții: | B≔2 ⋅ f+((z-1)) ⋅ e=28 mm
34

m+n=11.5 mm
=> δ≔12 mm
δ≥m+n

δ1≔0.3 ⋅B=8.4 mm

dc≔1.6 ⋅dca1=32 mm

di≔Dp2-2 ⋅m-2 ⋅ δ=135.465 mm

l≔lca1+2 mm =38 mm

Este îndeplinită condiția: l≥B

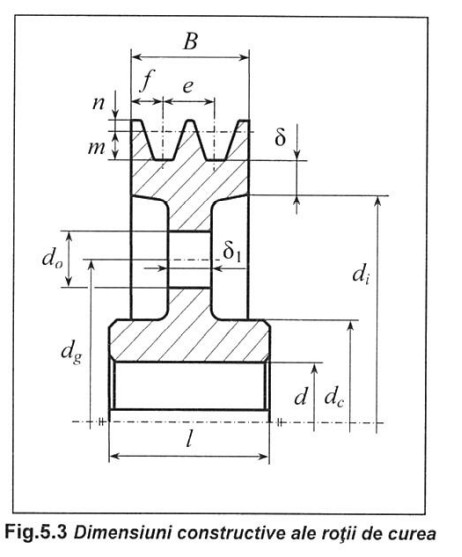
[picture p31: figure]

Cu scopul de a reduce greutatea roții de curea se prevede o serie de găuri.

dg≔0.5 ⋅ ⎛⎝di+dc

⎞
⎠=83.732 mm

da≔―――=

di-dc
4

25.866 mm

### 9. VERIFICAREA REDUCTORULUI:

### 9.1 Calculul reacțiunilor și momentelor încovoietoare:

Ft1=⎛⎝1.069 ⋅ 10³ ⎞

⎠ N | Ft2=⎛⎝1.069 ⋅ 10³ ⎞
⎠ N | S=623.367 N
Fr1=389.045 N | Fr2=389.045 N | l1≔62.3 mm
Fa1=0 N | Fa2=0 N | l2≔42.5 mm

Fn1=⎛⎝1.137 ⋅ 10³ ⎞

⎠ N | Fn2=⎛⎝1.137 ⋅ 10³ ⎞
⎠ N | l3≔43 mm

ARBORELE DE INTRARE:

-Calculul reacțiunilor:
În plan orizontal: | H1≔―――――――= S⋅ ⎛⎝ l1+2 l2 ⎞ ⎠+F ⋅ r1 l2 2 l2 | ⎛⎝1.275 ⋅ 10³ ⎞ ⎠ N
| H2≔――――= Fr1 ⋅l2-S⋅l1 2 ⋅l2 | -262.368 N
În plan vertical: | V1≔――= Ft1
| 2
534.447 N | 35

V2≔――=

Ft1
2

534.447 N

Reacțiunile rezultate: FR1≔ H
1

+ =

### 2 V1

2 ⎛⎝1.382 ⋅ 10³ ⎞
⎠ N

FR2≔ H
2

+ =

### 2 V2

2 595.374 N

-Calculul momentelor încovoietoare:

În plan orizontal: MiH2≔S⋅l1=⎛⎝3.884 ⋅ 10⁴ ⎞ ⎠ N ⋅mm

MiH31≔S⋅ ⎛⎝
l1+l2

⎞
⎠-H1

⋅l2=⎛⎝1.115 ⋅ 10⁴ ⎞
⎠ N ⋅mm

MiH32≔-H2

⋅l2=⎛⎝1.115 ⋅ 10⁴ ⎞
⎠ N ⋅mm

În plan vertical: MiV3≔-V1

⋅l2=-2.271 ⋅ 10⁴ N ⋅mm

Momentul rezultant: Mintrare≔ M
iH2

+ =

### 2 MiV3

2 ⎛⎝4.499 ⋅ 10⁴ ⎞
⎠ N ⋅mm

Cu ajutorul programului MDSolids am realizat diagramele pentru arborele de intrare:
Plan orizontal (H): | Plan vertical (V):

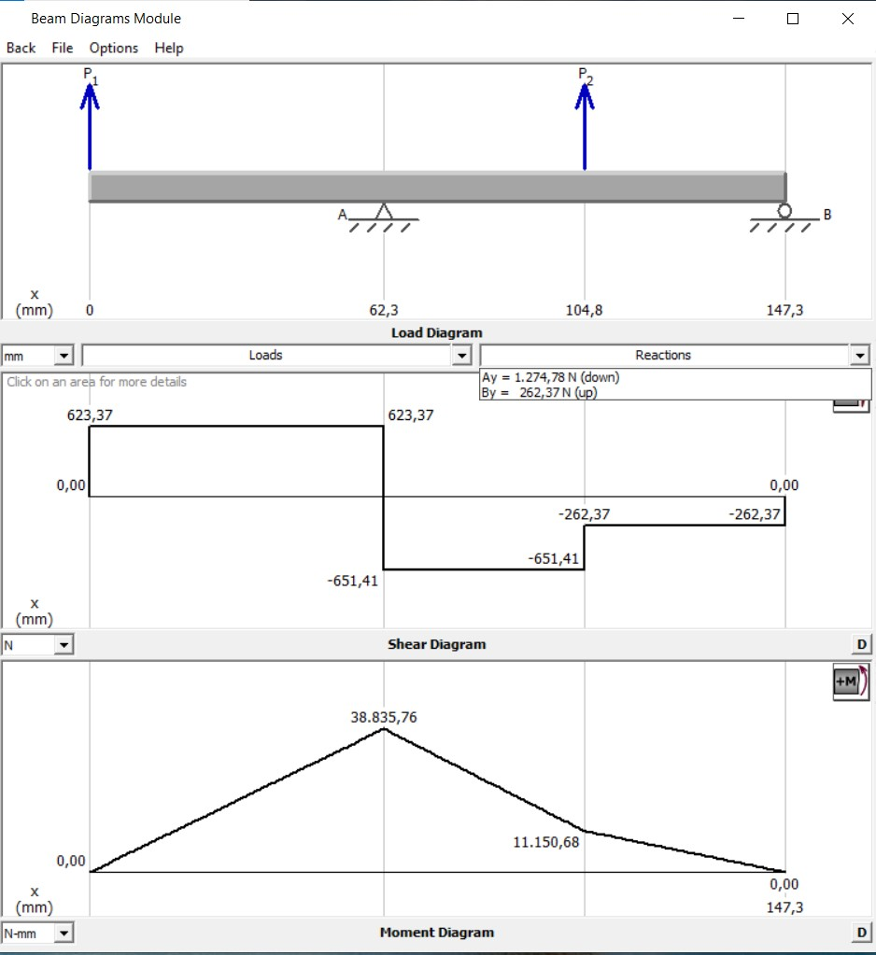
[picture p32: figure]

ARBORELE DE IEȘIRE:

-Calculul reacțiunilor:

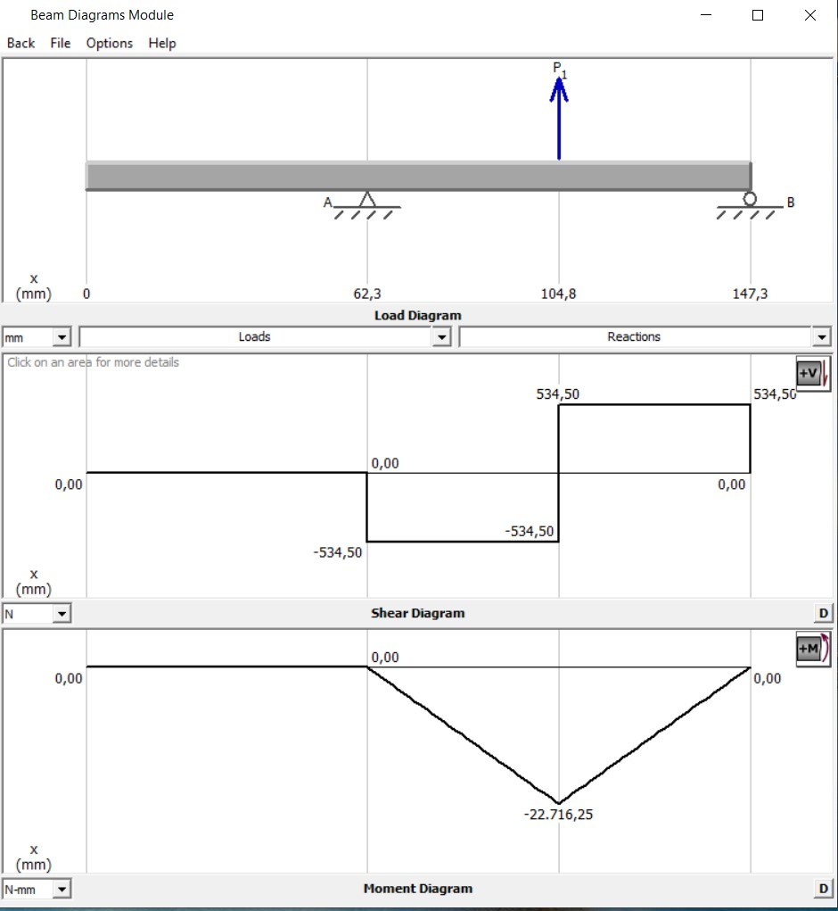
[picture p33: figure]

În plan orizontal: H3≔――=

Fr2
2

194.523 N

H4≔――=

Fr2
2

194.523 N

În plan vertical: V3≔――=

Ft2
2
534.447 N | 36

V4≔――=

Ft2
2

534.447 N

Reacțiunile rezultate: FR3≔ H
3

+ =

### 2 V3

2 568.746 N

FR4≔ H
4

+ =

### 2 V4

2 568.746 N

-Calculul momentelor încovoietoare:

În plan orizontal: MiH21≔H3

⋅l3=⎛⎝8.364 ⋅ 10³ ⎞
⎠ N ⋅mm

MiH22≔H4

⋅l4=⎛⎝9.143 ⋅ 10³ ⎞
⎠ N ⋅mm

În plan vertical: MiV2≔V3

⋅l3=⎛⎝2.298 ⋅ 10⁴ ⎞
⎠ N ⋅mm

Momentul rezultant: Miesire≔ M
iH21

+ =

### 2 MiV2

2 ⎛⎝2.446 ⋅ 10⁴ ⎞
⎠ N ⋅mm

Cu ajutorul programului MDSolids am realizat diagramele pentru arborele de ieșire:
Plan orizontal (H): | Plan vertical (V):

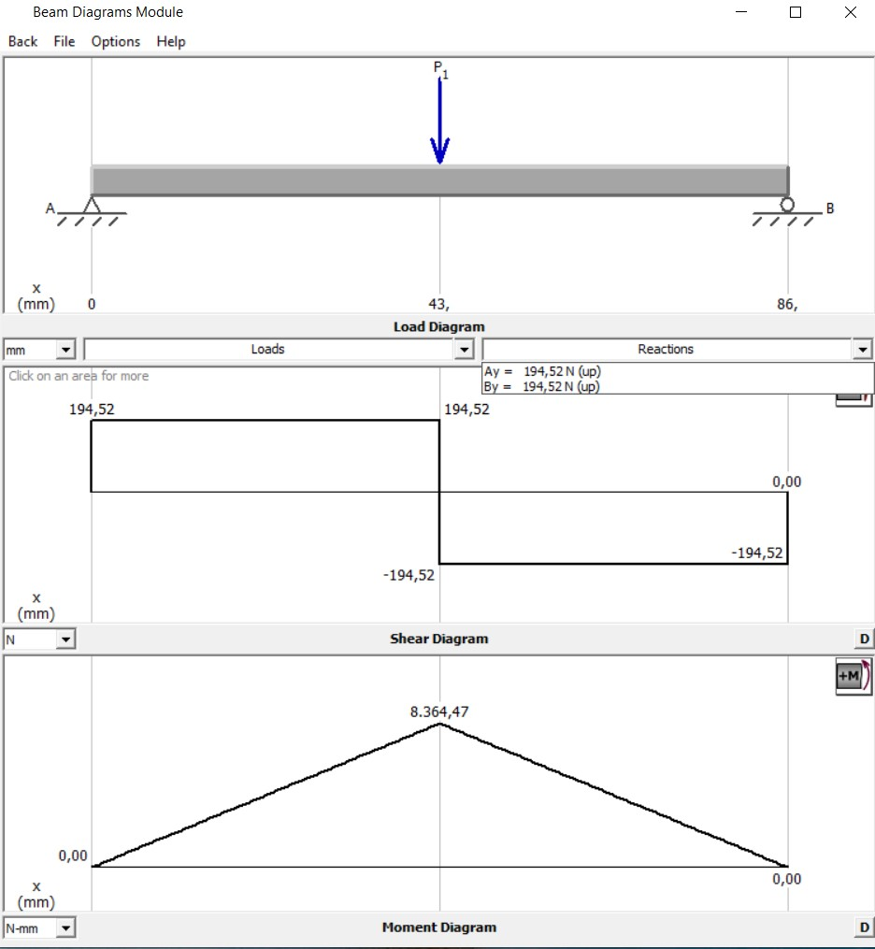
[picture p34: figure]

### 9.2 Verificarea arborilor:

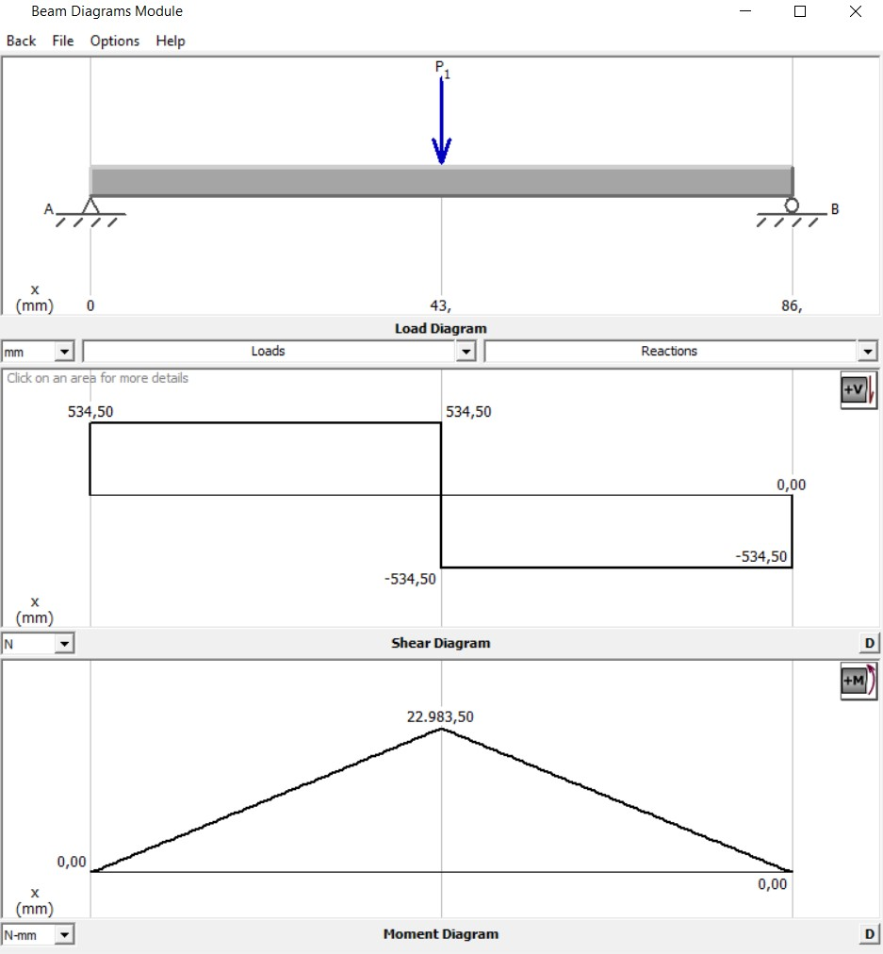
[picture p35: figure]

### 9.2.1 Verificarea la solicitări compuse:

ARBORELE DE INTRARE:

Se adopte tensiunea admisibilă la încovoiere pentru solicitarea alternant simetrică, cu ajutorul tabelului 3.6 de la pagina 73:

σai_1≔80 MPa
37

α≔――=

σai_1

σai_1

1

Wzin≔―――=

π⋅df1

3
32

⎛⎝1.407 ⋅ 10⁴ ⎞
⎠ mm³

Mi3≔ M
iH31

+ =

### 2 MiV3

2 ⎛⎝2.53 ⋅ 10⁴ ⎞
⎠ N ⋅mm

σech3≔――――――=

Mi3 +

2 ⎛⎝α⋅T1
⎞
⎠

2

Wzin

2.801 MPa => σech3≤σai_1

ARBORELE DE IEȘIRE:

Se adopte tensiunea admisibilă la încovoiere pentru solicitarea alternant simetrică, cu ajutorul tabelului 3.6 de la pagina 73:

σai_1≔70 MPa

α≔――=

σai_1

σai_1

1

Mi2≔ M
iH22

+ =

### 2 MiV2

2 ⎛⎝2.473 ⋅ 10⁴ ⎞
⎠ N ⋅mm
Wzie≔―――- | =

π⋅d42

3
32 ―――――――――
b | ⋅ | ⋅ pana2 tpana2 ⎛⎝d42-tpana2⎞
⎠

2

2 ⋅d42

⎛⎝5.321 ⋅ 10³ ⎞
⎠ mm³

σech2≔――――――=

Mi2 +

2 ⎛⎝α⋅T2
⎞
⎠

2

Wzie

| 14.714 MPa | => σech2≤σai_1

### 9.2.2 Verificarea la oboseală:

ARBORELE DE INTRARE:

-materialul arborelui de intrare este: 42CrMo4

Rm1=950 MPa | Rp0.2≔750 MPa | τc≔420 MPa
σ_1≔460 MPa | τ_1≔320 MPa | ca≔1.5
a) PANA:

Se adoptă, cu ajutorul anexei 3.12, coeficienți de concentrare a tensiunilor, factori dimensionali, factori de calitate ai suprafeței: 38

βkσ≔2 | εσ≔0.92 | γσ≔1
βkτ≔1.9 | ετ≔0.92 | γτ≔1

Mi≔ M
iH2

=

2 ⎛⎝3.884 ⋅ 10⁴ ⎞
⎠ N ⋅mm
Wz≔―――- | =

π⋅dca1

3
32 ―――――――――
b | ⋅ | ⋅ pana1 tpana1 ⎛⎝dca1-tpana1⎞
⎠
| | 2

2 ⋅dca1

642.467 mm³

σImax≔――=

Mi
Wz
60.448 MPa | σV≔σImax=60.448 MPa

σm ≔0 MPa

Wp≔―――- | =

π⋅dca1

3
16 ―――――――――
b | ⋅ | ⋅ pana1 tpana1 ⎛⎝dca1-tpana1⎞
⎠

2

2 ⋅dca1

⎛⎝1.428 ⋅ 10³ ⎞
⎠ mm³

Ttmax≔――=

T1
Wp
21.172 MPa | TV≔――=

Ttmax
2

10.586 MPa

Tm ≔TV =10.586 MPa

Relațiile lui Soderberg:

cσ≔―――――――=

1

――⋅ +

βkσ
ε ⋅ σ γσ

――

σV

σ_1

――

σm

| Rp0.2

3.501

cτ≔――――――=

1

――⋅ | +
βkτ ε ⋅ τ γτ | ――

TV

τ_1

――

Tm
τc

10.692

c≔――――=

c ⋅ σ cτ
+ cσ

2
cτ

2

3.327 => c≥ca

b) PINIONUL:

Se adoptă, cu ajutorul anexei 3.12, coeficienți de concentrare a tensiunilor, factori dimensionali, factori de calitate ai suprafeței:

βkσ≔1.75 | εσ≔0.88 | γσ≔1
βkτ≔1.6 | ετ≔0.88 | γτ≔1 | 39

Mi≔ M
iH32

+ =

### 2 MiV3

2 ⎛⎝2.53 ⋅ 10⁴ ⎞
⎠ N ⋅mm

Wz≔―――=

π⋅df1

3
32

⎛⎝1.407 ⋅ 10⁴ ⎞
⎠ mm³

σlmax≔――=

Mi
Wz
1.798 MPa | σV≔σlmax=1.798 MPa

σm ≔0 MPa

Wp≔―――=

π⋅df1

3
16

⎛⎝2.815 ⋅ 10⁴ ⎞
⎠ mm³

Ttmax≔――=

T1
Wp
1.074 MPa | TV≔――=

Ttmax
2

0.537 MPa

Tm ≔TV =0.537 MPa

Relațiile lui Soderberg:

cσ≔―――――――=

1

――⋅ +

βkσ
ε ⋅ σ γσ

――

σV

σ_1

――

σm

Rp0.2

128.659

cτ≔――――――=

1

――⋅ | +
βkτ ε ⋅ τ γτ | ――

TV

τ_1

――

Tm
τc

230.959

c≔――――=

c ⋅ σ cτ
+ cσ

2
cτ

2

112.396 | => | c≥ca
c) DEGAJAREA:

Se adoptă, cu ajutorul anexei 3.12, coeficienți de concentrare a tensiunilor, factori dimensionali, factori de calitate ai suprafeței:

βkσ≔2 | εσ≔0.9 | γσ≔1
βkτ≔1.65 | ετ≔0.9 | γτ≔1
40

Mi≔MiH2=⎛⎝3.884 ⋅ 10⁴ ⎞
⎠ N ⋅mm

Wz≔―――=

π⋅dr1

3
32

⎛⎝1.534 ⋅ 10³ ⎞
⎠ mm³

σlmax≔――=

Mi
Wz
25.317 MPa | σV≔σlmax=25.317 MPa

σm ≔0 MPa

Wp≔―――=

π⋅dr1

3
16

⎛⎝3.068 ⋅ 10³ ⎞
⎠ mm³

Ttmax≔――=

T1
Wp
9.854 MPa | TV≔――=

Ttmax
2

4.927 MPa

Tm ≔TV =4.927 MPa

Relațiile lui Soderberg:

cσ≔―――――――=

1

――⋅ +

βkσ
ε ⋅ σ γσ

――

σV

σ_1

――

σm

Rp0.2

8.176

cτ≔――――――=

1

――⋅ | +
βkτ ε ⋅ τ γτ | ――

TV

τ_1

――

Tm
τc

25.026

c≔――――=

c ⋅ σ cτ
+ cσ

2
cτ

2

7.772 | => | c≥ca

ARBORELE DE IEȘIRE:

-materialul arborelui de intrare este: 1C55

Rm2=720 MPa | Rp0.2≔410 MPa | τc≔280 MPa
σ_1≔340 MPa | τ_1≔190 MPa | ca≔1.5
a) PANA 1:(d=28 mm)

Se adoptă, cu ajutorul anexei 3.12, coeficienți de concentrare a tensiunilor, factori dimensionali, factori de calitate ai suprafeței: 41

βkσ≔2 | εσ≔0.88 | γσ≔1
βkτ≔1.9 | ετ≔0.88 | γτ≔1

Mi≔ M
iH22

+ =

### 2 MiV2

2 ⎛⎝2.473 ⋅ 10⁴ ⎞
⎠ N ⋅mm
Wz≔―――- | =

π⋅dca2

3
32 ―――――――――
b | ⋅ | ⋅ pana2 tpana2 ⎛⎝dca2-tpana2⎞
⎠
| | 2

2 ⋅dca2

⎛⎝1.826 ⋅ 10³ ⎞
⎠ mm³

σImax≔――=

Mi
Wz
13.545 MPa | σV≔σImax=13.545 MPa

σm ≔0 MPa

Wp≔―――- | =

π⋅dca2

3
16 ―――――――――
b | ⋅ | ⋅ pana2 tpana2 ⎛⎝dca2-tpana2⎞
⎠

2

2 ⋅dca2

⎛⎝3.981 ⋅ 10³ ⎞
⎠ mm³

Ttmax≔――=

T2
Wp
18.659 MPa | TV≔――=

Ttmax
2

### 9.33 MPa

Tm ≔TV =9.33 MPa

Relațiile lui Soderberg:

cσ≔―――――――=

1

――⋅ +

βkσ
ε ⋅ σ γσ

――

σV

σ_1

――

σm

| Rp0.2

11.045

cτ≔――――――=

1

――⋅ | +
βkτ ε ⋅ τ γτ | ――

TV

τ_1

――

Tm
τc

7.177

c≔――――=

c ⋅ σ cτ
+ cσ

2
cτ

2

6.018 | => | c≥ca
b) PANA 2: (d=39 mm)

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

βkσ≔2 | εσ≔0.88 | γσ≔1
βkτ≔1.9 | ετ≔0.88 | γτ≔1 | 42

Mi≔ M
iH22

+ =

### 2 MiV2

2 ⎛⎝2.473 ⋅ 10⁴ ⎞
⎠ N ⋅mm

Dimensiunile pentru pana sunt:

b≔12 mm | h≔8 mm | t≔5 mm
Wz≔―――- | =

π⋅d42

3
32 ―――――
| b ⋅t⋅ ⎛⎝d42-t⎞
⎠

2
| 2 ⋅d42 | ⎛⎝4.934 ⋅ 10³ ⎞
⎠ mm³

σImax≔――=

Mi Wz | 5.012 MPa | σV≔σImax=5.012 MPa

σm ≔0 MPa

Wp≔―――- | =

π⋅d42

3
16 ―――――
| b ⋅t⋅ ⎛⎝d42-t⎞
⎠

2
| 2 ⋅d42 | ⎛⎝1.076 ⋅ 10⁴ ⎞
⎠ mm³

Ttmax≔――=

T2
Wp
6.905 MPa | TV≔――=

Ttmax
2

3.452 MPa

Tm ≔TV =3.452 MPa

Relațiile lui Soderberg:

cσ≔―――――――=

1

――⋅ +

βkσ
ε ⋅ σ γσ

――

σV

σ_1

――

σm

Rp0.2

29.846

cτ≔――――――=

1

――⋅ | +
βkτ ε ⋅ τ γτ | ――

TV

τ_1

――

Tm
τc

19.394

c≔――――=

c ⋅ σ cτ
+ cσ

2
cτ

2

16.262 => c≥ca

c)DEGAJAREA:

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

βkσ≔2.2 | εσ≔0.86 | γσ≔1
βkτ≔1.68 | ετ≔0.86 | γτ≔1 | 43

Mi≔ M
iH21

+ =

### 2 MiV2

2 ⎛⎝2.446 ⋅ 10⁴ ⎞
⎠ N ⋅mm

Wz≔―――=

π⋅dr2

3
32

⎛⎝4.209 ⋅ 10³ ⎞
⎠ mm³

σlmax≔――=

Mi
Wz
5.81 MPa | σV≔σlmax=5.81 MPa

σm ≔0 MPa

Wp≔―――=

π⋅dr2

3
16

⎛⎝8.418 ⋅ 10³ ⎞
⎠ mm³

Ttmax≔――=

T2
Wp
8.824 MPa | TV≔――=

Ttmax
2

4.412 MPa

Tm ≔TV =4.412 MPa

Relațiile lui Soderberg:

cσ≔―――――――=

1

――⋅ +

βkσ
ε ⋅ σ γσ

――

σV

σ_1

――

σm

Rp0.2

22.876

cτ≔――――――=

1

――⋅ | +
βkτ ε ⋅ τ γτ | ――

TV

τ_1

――

Tm
τc

16.362

c≔――――=

c ⋅ σ cτ
+ cσ

2
cτ

2

13.308 | => | c≥ca

### 9.3 Verificarea penelor:

ARBORELE DE INTRARE:

-materialul penei este: E335

σas≔35 MPa
=> σs≤σas

σs≔―――――=

4 ⋅T1

h | ⋅ | ⋅ pana1 lca1 dca1

27.992 MPa

44

τaf≔32 MPa
=> τf≤τaf

τf≔――――――=

2 ⋅T1

b | ⋅ | ⋅ pana1 lpana1 dca1

15.745 MPa

ARBORELE DE IEȘIRE:

a) PANA 1:(d=28 mm)

-materialul penei este: E335

σas≔35 MPa
=> σs≤σas

σs≔―――――=

4 ⋅T2

h | ⋅ | ⋅ pana2 lca2 dca2

25.267 MPa

τaf≔32 MPa
=> τf≤τaf

τf≔――――――=

2 ⋅T2

b | ⋅ | ⋅ pana2 lpana2 dca2

13.265 MPa

b) PANA 2: (d=39 mm)

-materialul penei este: E335

σas≔35 MPa
=> σs≤σas

σs≔―――=

4 ⋅T2
h⋅l⋅d42

25.062 MPa

τaf≔32 MPa
=> τf≤τaf

τf≔―――=

2 ⋅T2
b ⋅l⋅d42

8.354 MPa

45

### 9.4 Verificarea rulmenților:

Pentru acest tip de reductor se folosesc rulmenți radiali cu bile.

ARBORELE DE INTRARE:

FR1=⎛⎝1.382 ⋅ 10³ ⎞
⎠ N | FR2=595.374 N

FR1>FR2

a) Rulmentul 1:

C1≔44800 N

Pe1≔FR1=⎛⎝1.382 ⋅ 10³ ⎞
⎠ N

Lh≔―――⋅

10⁶
60 ⋅n1

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
Lh≔34400 hr
=> Lhnec≤Lh
Lhnec≔20000 hr
b) Rulmentul 2:

C1=⎛⎝4.48 ⋅ 10⁴ ⎞
⎠ N

Pe2≔FR2=595.374 N

Lh≔―――⋅

10⁶
60 ⋅n1

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
Lh≔23800 hr
=> Lhnec≤Lh
Lhnec≔20000 hr

ARBORELE DE IEȘIRE:

FR3=568.746 N | FR4=568.746 N

FR1≥FR2

46

a) Rulmentul 3:

C2=⎛⎝3.35 ⋅ 10⁴ ⎞
⎠ N

Pe3≔FR3=568.746 N

Lh≔―――⋅

10⁶
60 ⋅n1

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
Lh≔21700 hr
=> Lhnec≤Lh
Lhnec≔20000 hr
b) Rulmentul 4:

C2=⎛⎝3.35 ⋅ 10⁴ ⎞
⎠ N

Pe4≔FR4=568.746 N

Lh≔―――⋅

10⁶
60 ⋅n1

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
Lh≔21700 hr
=> Lhnec≤Lh
Lhnec≔20000 hr

47
