banatanflorin/reductor/(list of files, cad)

Other CAD files:
arbore de intrare.dwg
Desen O.M.2.dwg
roata dintata.dwg
